tigran-abgaryan/heater-autoswitch/pcb_back_83x60_250dpi.png

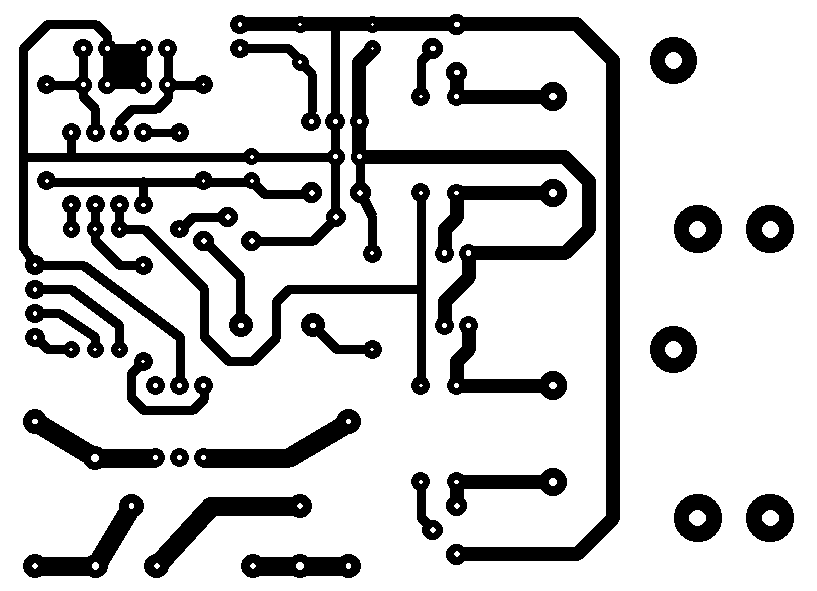
pcb_back_83x60_250dpi.png
