tigran-abgaryan/heater-autoswitch/pcb_front_83x60_250dpi.png

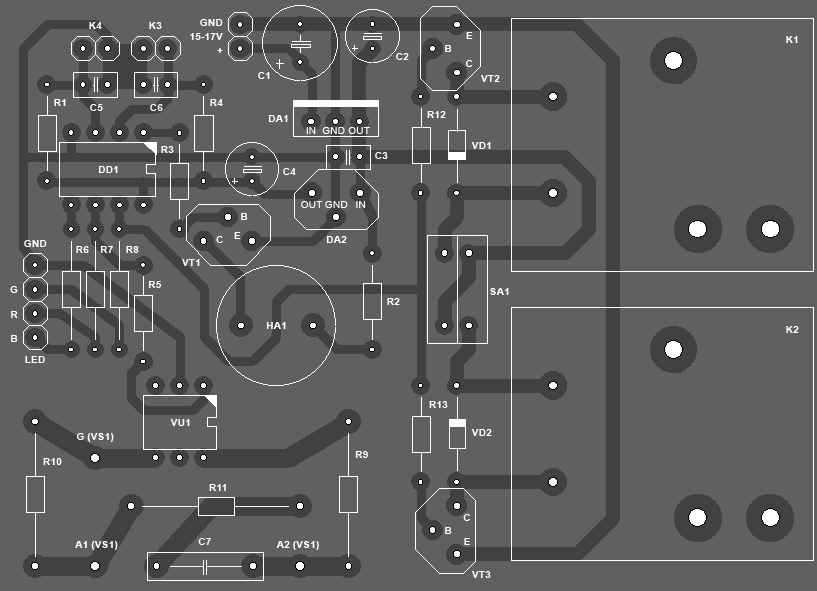
pcb_front_83x60_250dpi.png
