tigran-abgaryan/heater-autoswitch/SMPS.jpg

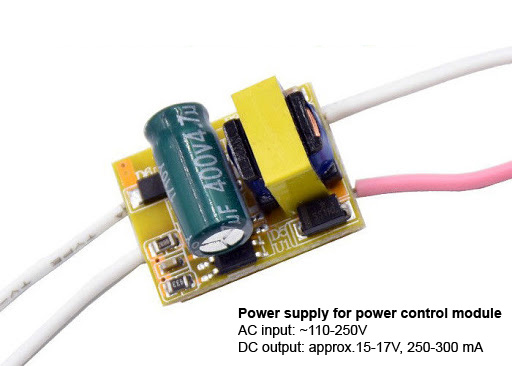
SMPS.jpg
