tigran-abgaryan/heater-autoswitch/(list of files, drawings)

Other design files:
pcb.lay
